socialbodylab/buzz-bites/README.md

# buzz-bites

Experimental vibe motor modules for building haptic projects.
