socialbodylab/buzz-bites/driver/production/bom.csv

Designator | Footprint | Quantity | Value | LCSC Part #
C1 | C_Disc_D5.0mm_W2.5mm_P5.00mm | 1 | 10u
D1 | D_DO-41_SOD81_P7.62mm_Horizontal | 1 | 1N4148
H1, H2, H3 | rounded_3pin | 3 | MountingHole_Pad
J1 | PinHeader_1x03_P2.54mm_Vertical | 1 | Conn_01x03_Pin
M1 | VIBE-MOTOR-10MM-SMD | 1 | Motor
Q1 | TO-92_Inline_W4.0mm_Horizontal_FlatSideDown | 1 | BS170
R1 | R_Axial_DIN0207_L6.3mm_D2.5mm_P7.62mm_Horizontal | 1 | 100
R2 | R_Axial_DIN0207_L6.3mm_D2.5mm_P7.62mm_Horizontal | 1 | 10K
U$2_2, U$2 | SYMBOL_PLUS | 2
U$3_2, U$3 | SYMBOL_MINUS | 2
