socialbodylab/buzz-bites/driver/production/buzz-driver_bom.csv

Designator | Footprint | Quantity | Value | LCSC Part #
C1 | C_Disc_D5.0mm_W2.5mm_P5.00mm | 1 | 100n
D1 | D_DO-41_SOD81_P7.62mm_Horizontal | 1 | 1N4148
H1 | rounded_3pin | 1 | Signal
H2 | rounded_3pin | 1 | 5V
H3 | rounded_3pin | 1 | GND
J1 | PinHeader_1x03_P2.54mm_Vertical | 1 | Conn_01x03_Pin
M1 | new_vibe_motor | 1 | Motor
Q1 | TO-92_W4.0mm_StaggerEven_Horizontal_FlatSideDown | 1 | BS170
R1 | R_Axial_DIN0207_L6.3mm_D2.5mm_P10.16mm_Horizontal | 1 | 100
R2 | R_Axial_DIN0207_L6.3mm_D2.5mm_P10.16mm_Horizontal | 1 | 10K
U$2_4, U$2_3, U$2_2, U$2 | SYMBOL_PLUS | 4
U$3_4, U$3_3, U$3_2, U$3 | SYMBOL_MINUS | 4
