socialbodylab/buzz-bites/simple-a-b/simple-a-b.kicad_pcb

## KiCad design simple-a-b/simple-a-b.kicad_pcb (2026-08-12)

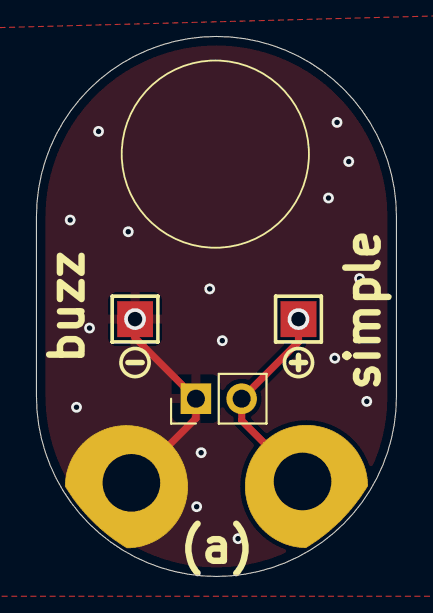
[picture p1: board simple-a-b.kicad_pcb from above]

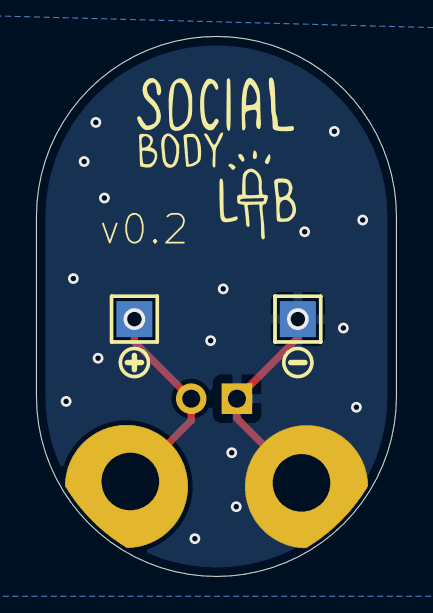
[picture p2: board simple-a-b.kicad_pcb from below]

Board: 2 copper layers, 20.0 x 30.0 mm, 11 parts (4 on the bottom side), 2 nets.

Parts:
H1, H2: MountingHole_Pad; edge_tiny
J1: Conn_01x02_Pin; PinHeader_1x02_P2.54mm_Vertical
J2, J3: TESTPOINT_PAD_2MM
TP3, TP4: TESTPOINT_PAD_2MM
U$2, U$2#2: SYMBOL_PLUS
U$3, U$3#2: SYMBOL_MINUS

Connections:
GND: H2.1, J1.1, J3.Pin_1, TP4.Pin_1
unnamed: H1.1, J1.2, J2.Pin_2, TP3.1
