socialbodylab/buzz-bites/docs/assembly.md

# Assembly steps

All the boards use the same motor preparation and placement. The following section contains what you will need to assemble each board. Followed by specific assembly for the more complex boards.

## What you need for each board

### Buzz Simple boards a, b, c

For these boards you will only need a vibration motor.

Simple (a) parts
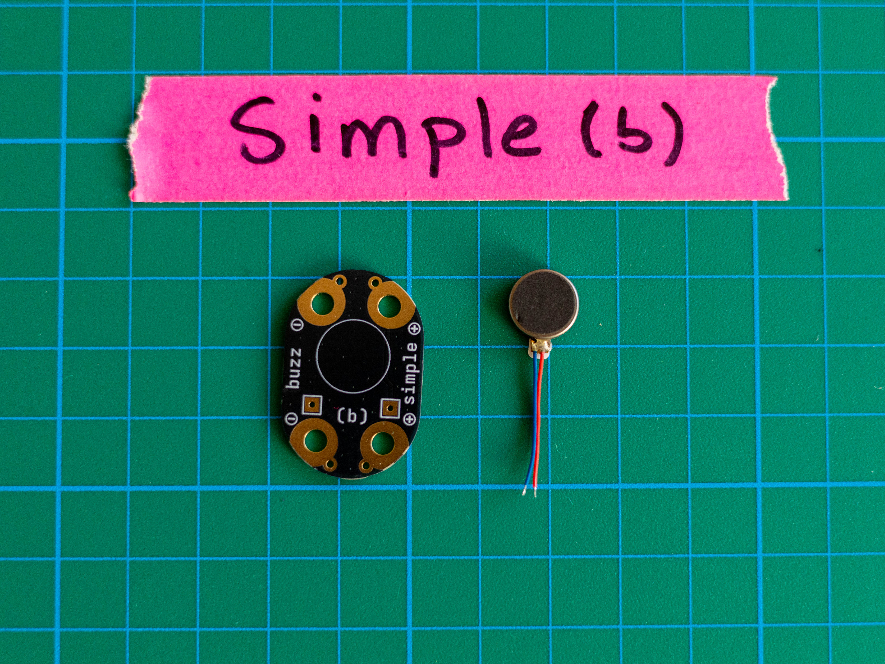
[picture p3: docs/imgs/simple-b-parts.jpg]
Simple (b) parts

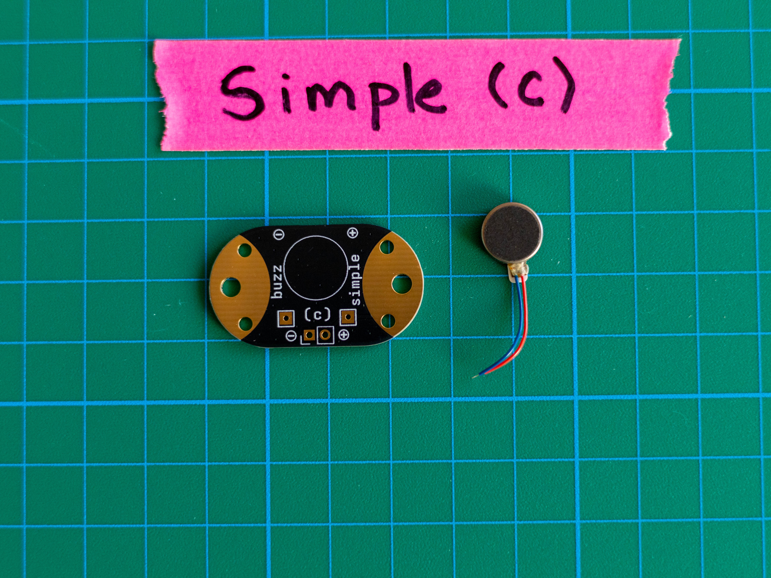
[picture p4: docs/imgs/simple-c-parts.jpg]
Simple (c) parts


### Buzz Breakout

The breakout board allows for two configurations.
(1) 220 ohm current limiting resistor (cut jumper JP1).
(2) flyback diode only (solder jumper JP1 if previously cut).

Breakout parts

#### BOM

| Qty | Value | Package | Designator | Part number |
| :-- | --- | --- | --- | --- |
| 1 | 1N4148 | DO-35 | D1 | onsemi - 1N4148 |
| 1 | 220R, 1/4W, 1% | - | R1 | YAGEO - MFR-25FBF52-220R |

### Buzz Driver

The driver board is designed to accommodate different sizes of resistors, and capacitors. The BS170 MOSFET could be replaced with other options that share the same pinout. For convenience the pins are marked drain (D), gate (G) and source (S).

Driver parts

#### BOM

| Qty | Value | Package | Designator | Part number |
| :-- | --- | --- | --- | --- |
| 1 | .1uF, ceramic, 50V, 10% | Leaded 5mm | C1 | Vishay - K104K15X7RF5WH5 |
| 1 | 1N4148 | DO-35 | D1 | onsemi - 1N4148 |
| 1 | 100R, 1/4W, 1% | - | R1 | YAGEO - MFR-25FBF52-100R |
| 1 | 10K, 1/4W, 1% | - | R2 | YAGEO - MFR-25FBF52-10K  |
| 1 | MOSFET BS170[^1] | TO-92-3 | Q1 | onsemi - BS170 |

[^1]: Not all BS170 have the same pinout: original vs new have the gate and source flipped. We use the "original" pinout(Drain-Gate-Source). More information [here](https://www.ic-components.com/blog/the-ultimate-guide-to-n-channel-mosfets-key-applications-of-2n7000-and-bs170.jsp).

## Motor Preparation

Depending on the manufacturer of the motor, the motor wires vary in length. Step 2 can be omitted if the wires are already short.

1. Get your vibration motor
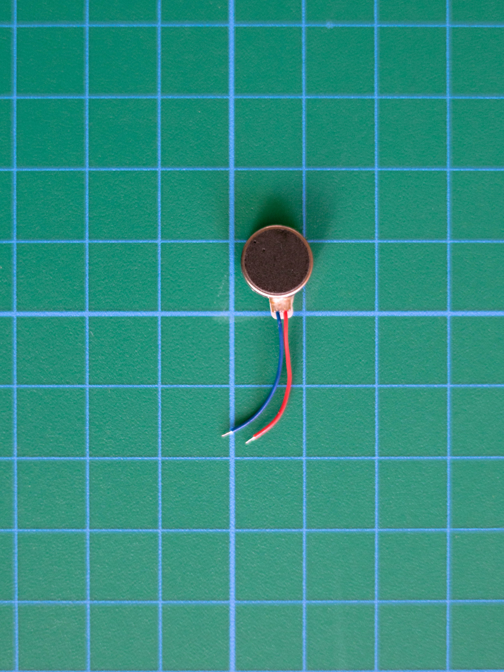
[picture p5: docs/imgs/single-motor.jpg]
Single vibration motor
   
2. Cut the motor wires to a 1cm (2/5in) length
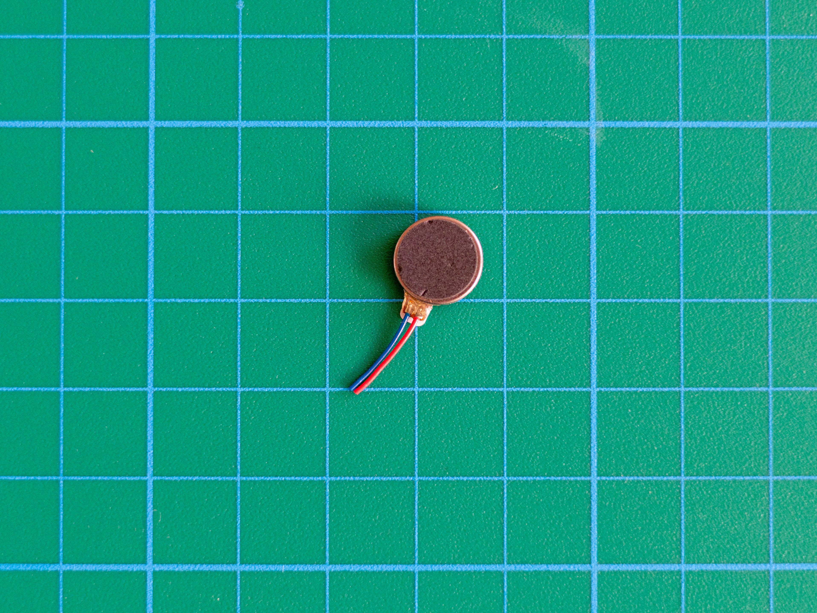
[picture p6: docs/imgs/short-wires.jpg]
Short wires
   Cutting wires 
3. Strip the motor wires around 0.4-0.5cm (1/5in) from the bottom
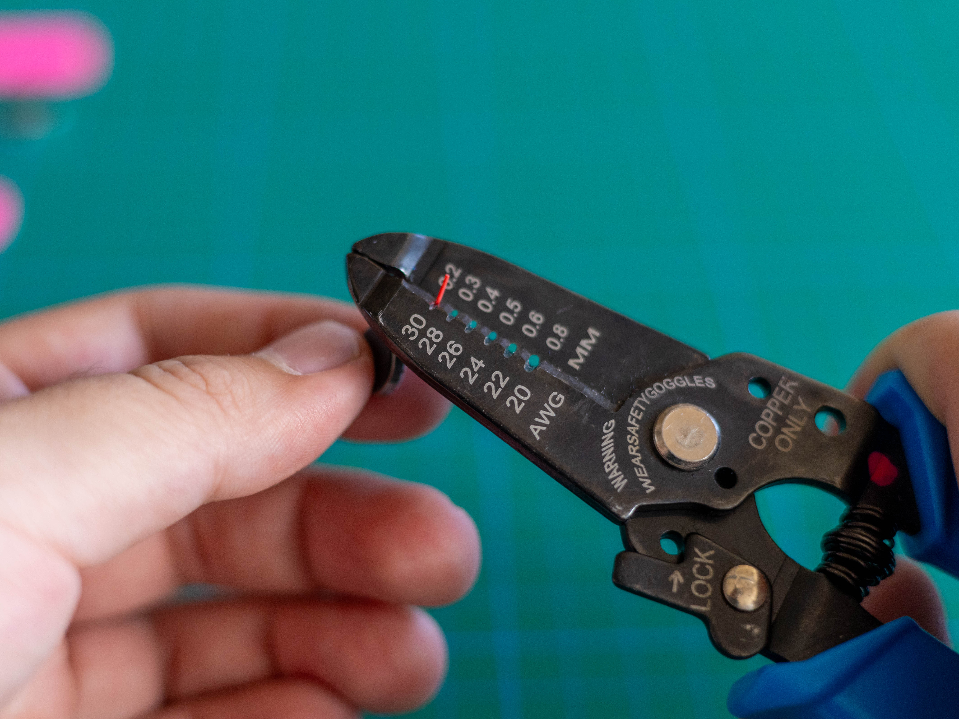
[picture p7: docs/imgs/strip-wire.jpg]
Stripping wires
    Stripped motor wires

## Motor placement

This section shows how to place and solder the vibration motor for all the boards. The process is exactly the same for all of them. Different boards are through the steps in this section.

1. Remove the protective layer from behind the motor
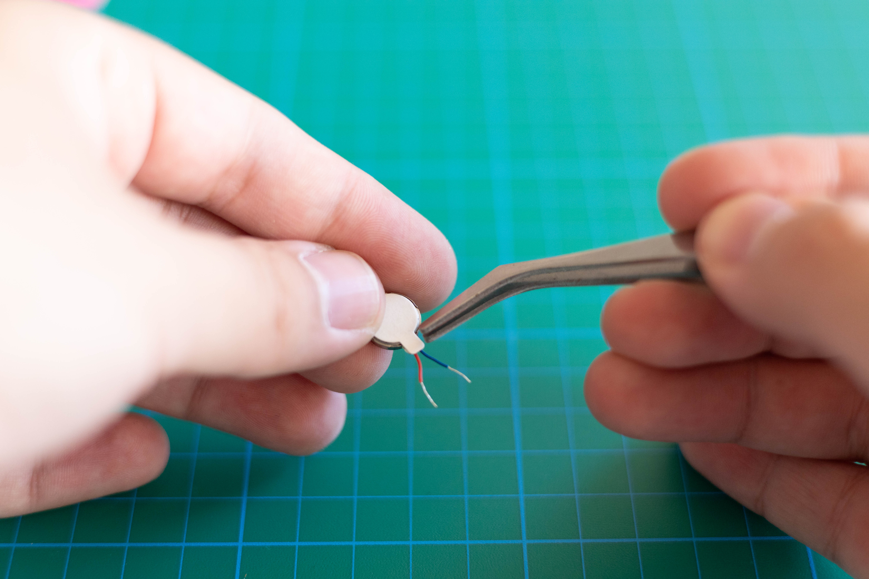
[picture p8: docs/imgs/remove-protection.jpg]
Removing protective layer
   
2. Insert the motor wires into the pad holes
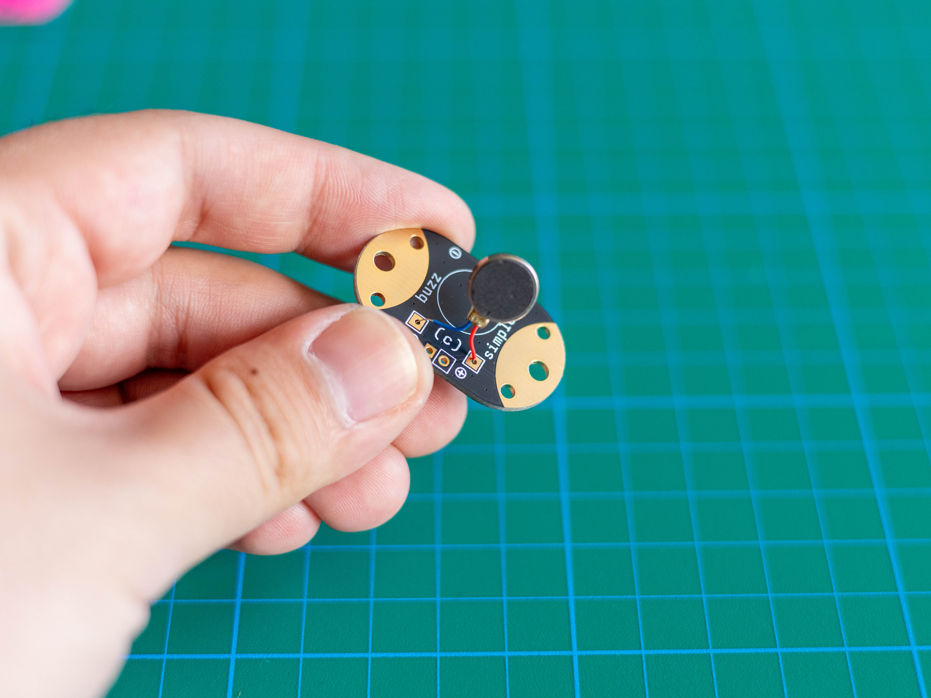
[picture p9: docs/imgs/insert-motor-wires.jpg]
Insert motor wires into pad holes
   
3. Align the motor to the circle outline on the PCB
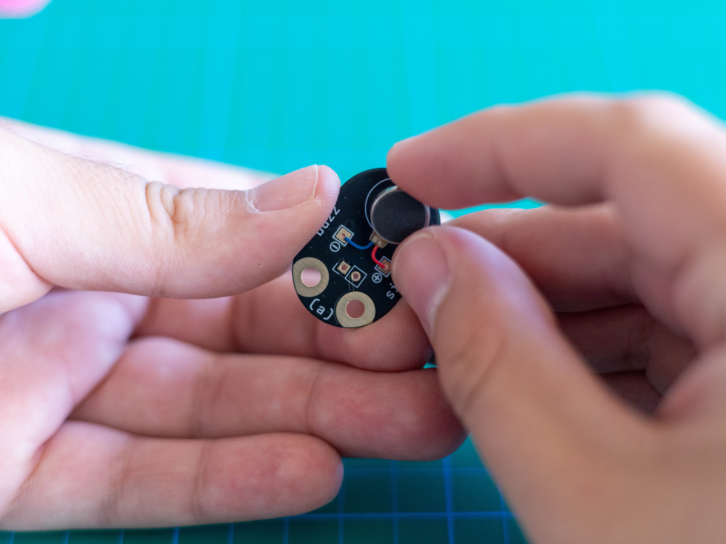
[picture p10: docs/imgs/align-motor.jpg]
Aligning the motor with the circle outline
   
4. Push the motor to the PCB
   Push motor
5. Solder motor wires to the pad
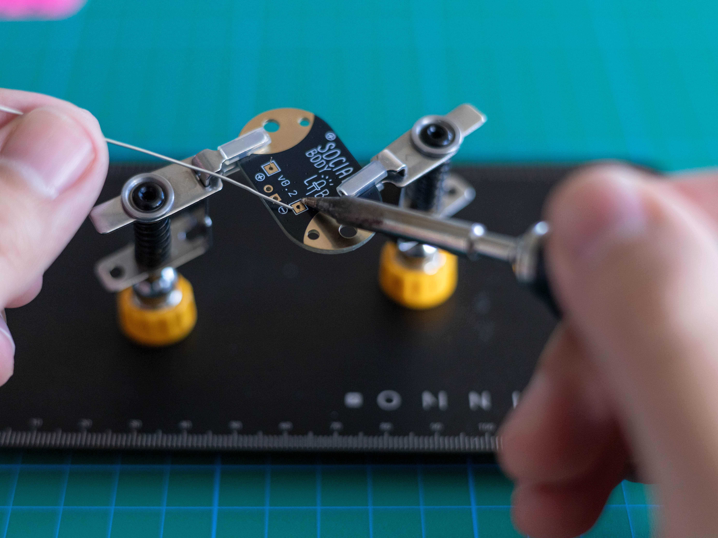
[picture p11: docs/imgs/solder-motor.jpg]
Soldering motor wires
   
6. Cut the excess wire
   Cut excess wire

> [!TIP]
> Use as little solder as possible and cut the excess wire flush for best results flat mounting.

## Buzz Breakout assembly

The resistor for the breakout board is optional. If you are going to use the resistor remember to cut the JP1 jumper (step 2).

1. Place the diode (align the indicator lines) and solder it
   Place the diode
2. Cut excess diode leads
   Cut excess diode leads
3. (optional) Cut the JP1 jumper if you are using the resistor
   Cut the JP1 jumper
4. (optional) Placing the resistor
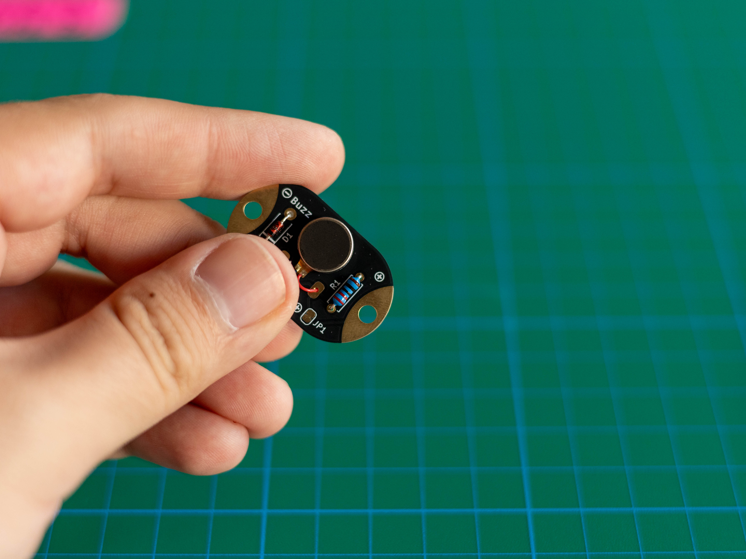
[picture p12: docs/imgs/resistor-placement.jpg]
Place R1 resistor
   
5. (optional) Solder Resistor and cut the excess leads
   Solder resistor

## Buzz Driver assembly

1. Bend the MOSFET leads 90 degrees
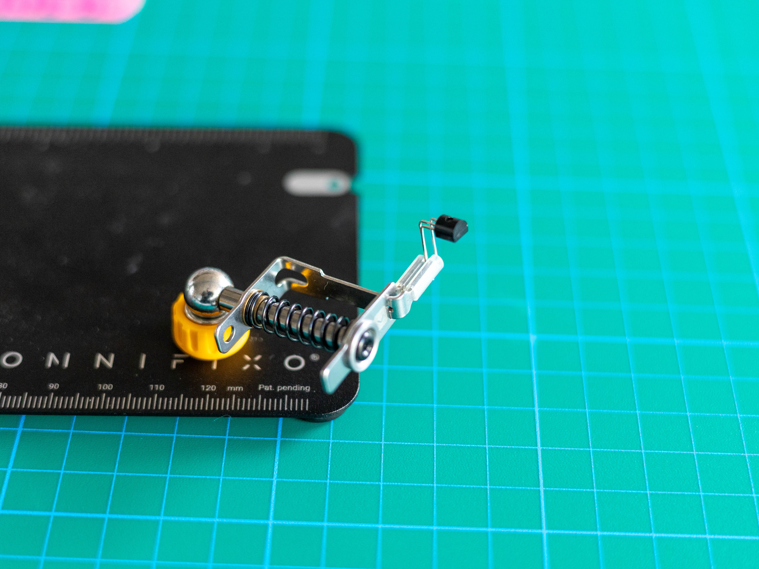
[picture p13: docs/imgs/bend-mosfet-leads.jpg]
Bend MOSFET leads 90 degrees
   
2. Place the MOSFET (round side up) and solder it
   Place MOSFET with the round side up
3. Place the diode D1 (align the indicator lines) and capacitor C1
   Place the diode D1 and capacitor C1
4. Place the Resistor R1(10K ohm) & R2(100 ohm) and solder
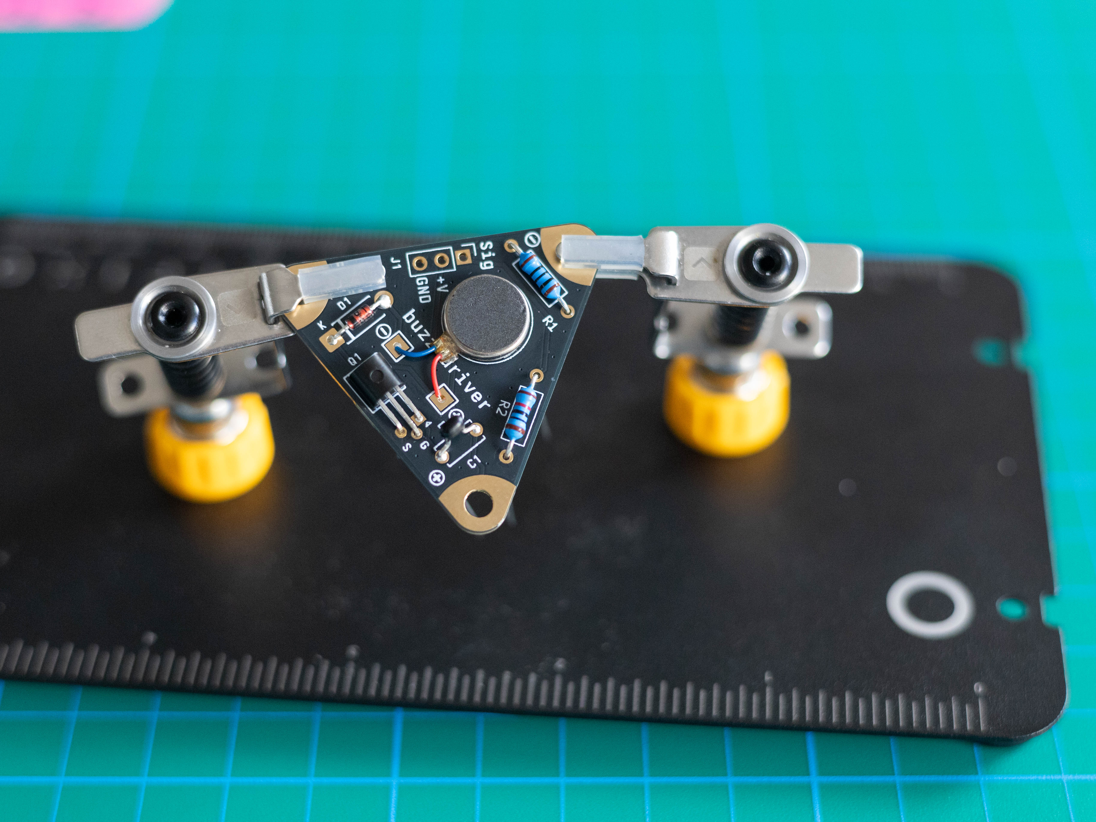
[picture p14: docs/imgs/place-r1-r2.jpg]
Place the resistors R1 and R2
   
5. Cut excess leads from all the components
   Cut the excess leads from all the components

### Final result

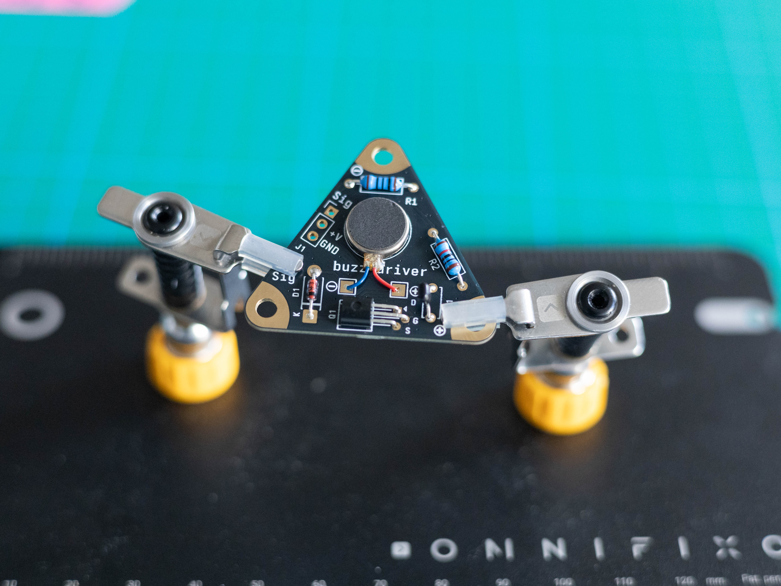
[picture p15: docs/imgs/driver-final.jpg]
Driver final result
