socialbodylab/buzz-bites/(commit log)

2026-08-12 added kicad projects
2026-10-01 Added assembly guide
